EklektikDezIn/MicroComputer-Design/Media/IMG_8726.JPG

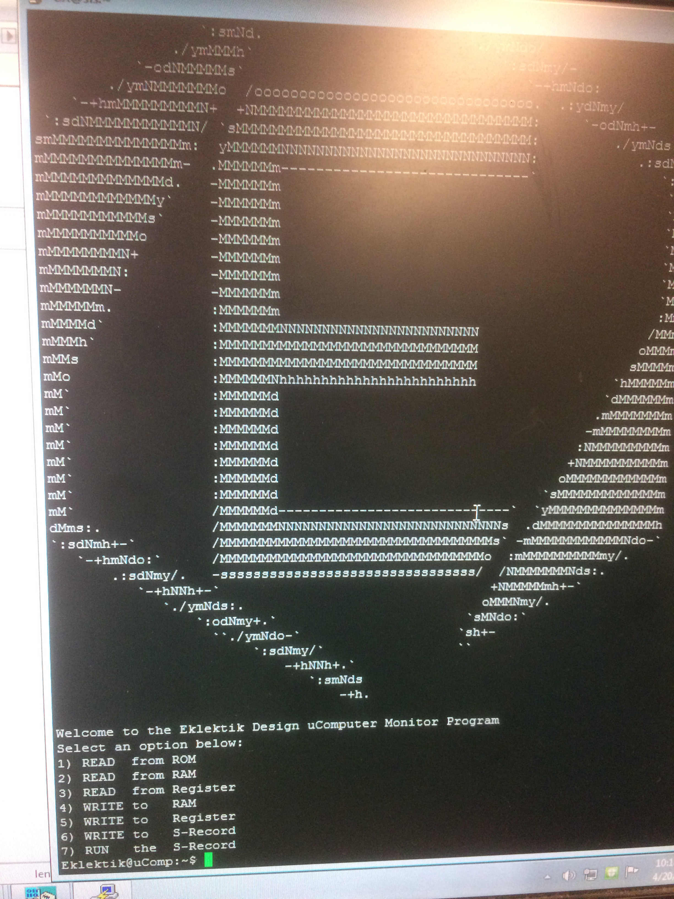
Media/IMG_8726.JPG
