EklektikDezIn/MicroComputer-Design/Media/IMG_8724.JPG

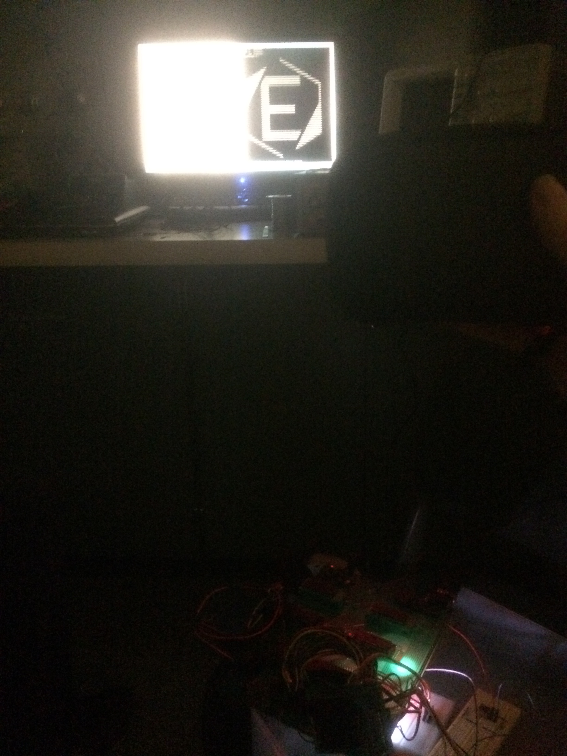
Media/IMG_8724.JPG
