EklektikDezIn/MicroComputer-Design/Reports/Weekly Reports/Report 1.docx

Time: 11 hours

Accomplishments:

- I have completed my initial part selection, however I still plan to meet with the lab assistants and my class mates to verify I have made no errors.
- I have yet to begin schematic drawings, in part due to the snow days which have cancelled classes.

Planned work:

- Next week I plan to confirm my part selection and begin ordering them from online.
- I would also like to complete a portion of the schematics.
- I also plan to diagram the basic flow of the monitor program.

I realize this may be much, but I would prefer to set high goals and fail than to get behind due to not pushing myself. I have allocated 7 hours outside of class to work on this project through the week. I believe it is sufficient for the time being, though I shall extend as needed.

Project % complete:

Hardware: 2%

Software : 0%

Micah Richards Microcomputer Design January 17, 2018
