EklektikDezIn/MicroComputer-Design/Reports/Weekly Reports/Report 2.docx

Time: 9 hours

Accomplishments:

- I expected to begin ordering parts, and I have. I forgot a DIP socket for my CPU and must order that this next week.
- I also began work on the schematics, as planned.
- I completed the software diagram of the code.

Planned work:

- I plan to complete my schematic designs this week and begin work on the PCB symbols.
- I will order the missing DIP socket

Project % complete:

Hardware: 10%

Software : 2%

Micah Richards Microcomputer Design January 24, 2018
