EklektikDezIn/MicroComputer-Design/Reports/Weekly Reports/Report 3.docx

Time: 10 hours

Accomplishments:

- I planned to complete my final schematic design, while it is mostly complete I have many questions which I would like to discuss with the lab assistants before I move forward to the PCB design
- I also planned to begin work on the PCB symbols for the board, and in actuality have completed the entire set.

Planned work:

- This next week I plan to finalize my schematic design through meetings with Chandler and Brian
- I also plan to begin work on the PCB layout during my own scheduled uComp time

Project % complete:

Hardware: 40%

Software : 2%

Micah Richards Microcomputer Design January 31, 2018
