EklektikDezIn/MicroComputer-Design/Reports/Weekly Reports/Report 5.docx

Time: 14 hours

Accomplishments:

- Last week I expected to complete my schematic and finish the first draft of my PCB schematic. Both are complete.

Planned work:

- This week I plan to go through each datasheet and verify pin layouts, chip sizes, needed and unneeded pins, etc. And make appropriate changes to my schematic and data sheet
- Possibly order my board

Project % complete:

Hardware: 58%

Software : 2%

Micah Richards Microcomputer Design February 14, 2018
