EklektikDezIn/MicroComputer-Design/Reports/Weekly Reports/Report 6.docx

Time: 2 hours

Accomplishments:

- Last week I expected to double check my work and order my board. This was done.

Planned work:

- I am uncertain if my board will arrive before the end of this week. If it does, I plan to complete the soldering of components before Wednesday.

Project % complete:

Hardware: 60%

Software : 2%

Micah Richards Microcomputer Design March 5, 2018
