EklektikDezIn/MicroComputer-Design/Reports/Weekly Reports/Report 8.docx

Time: 30 hours

Accomplishments:

- Last report I received my board with a large mistake, this week I have the breakout board assembled and (nearly) fully connected to my board.
- I have drafted the CPLD and ROM Code
- I am beginning work on RAM/ROM testing

Planned work:

- This week I plan to complete the requirements due today for the Software check.
- I may begin more detailed work on my monitor program

Project % complete:

Hardware: 95%

Software : 30%

Micah Richards Microcomputer Design March 21, 2018
