EklektikDezIn/MicroComputer-Design/Reports/Weekly Reports/Charts.xlsx

Week | Hours | Hardware | Software
1 | 11 | 2 | 0
2 | 9 | 10 | 2
3 | 10 | 40 | 2
4 | 8 | 50 | 2
5 | 14 | 58 | 2
6 | 2 | 60 | 2
7 | 5 | 60 | 2
8 | 30 | 95 | 30
9 | 22.5 | 95 | 35
10 | 5 | 100 | 97
11 | 12 | 97 | 97
12 | 5 | 100 | 100
