EklektikDezIn/MicroComputer-Design/Hardware/Datasheets/Barrel Plug Annotated.PNG

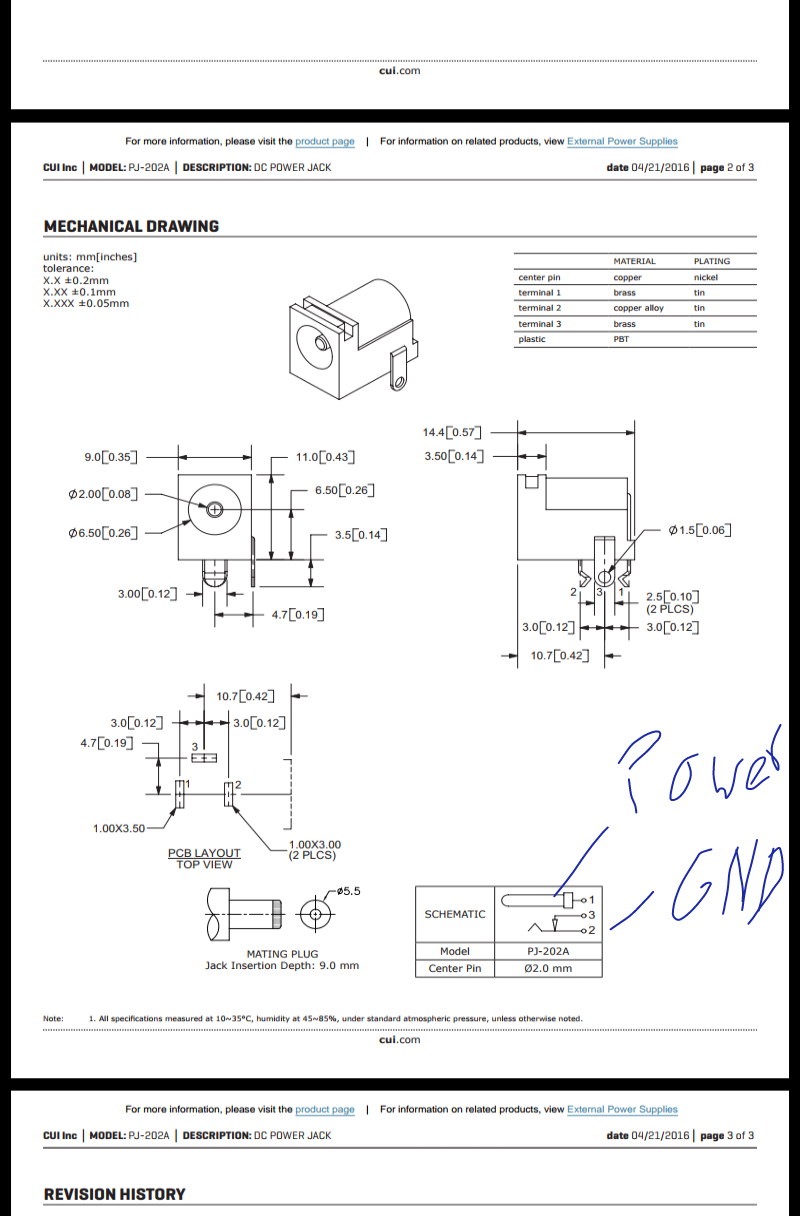
Hardware/Datasheets/Barrel Plug Annotated.PNG
