EklektikDezIn/MicroComputer-Design/Hardware/Datasheets/Pin Layouts/7128_pinout.jpg

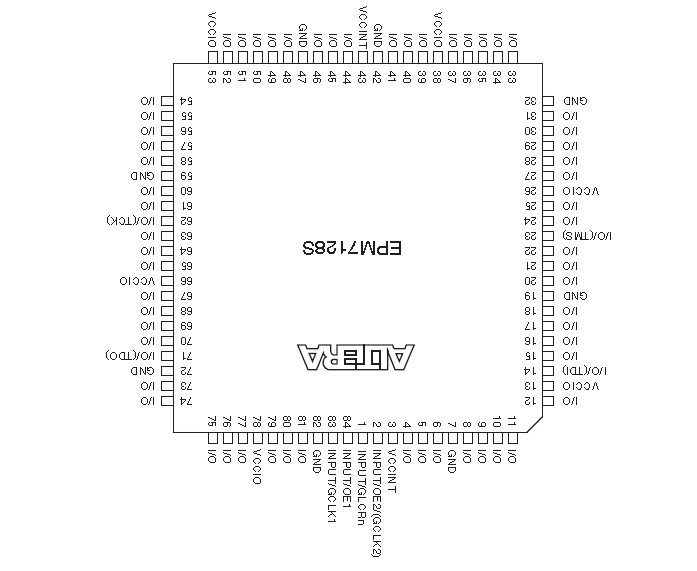
Hardware/Datasheets/Pin Layouts/7128_pinout.jpg
