EklektikDezIn/MicroComputer-Design/Hardware/Datasheets/Pin Layouts/L6515-pinout.jpg

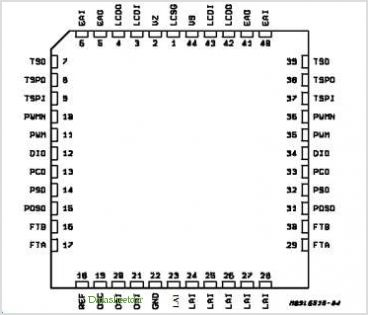
Hardware/Datasheets/Pin Layouts/L6515-pinout.jpg
