EklektikDezIn/MicroComputer-Design/Hardware/Datasheets/Pin Layouts/PLCC to DIP.PNG

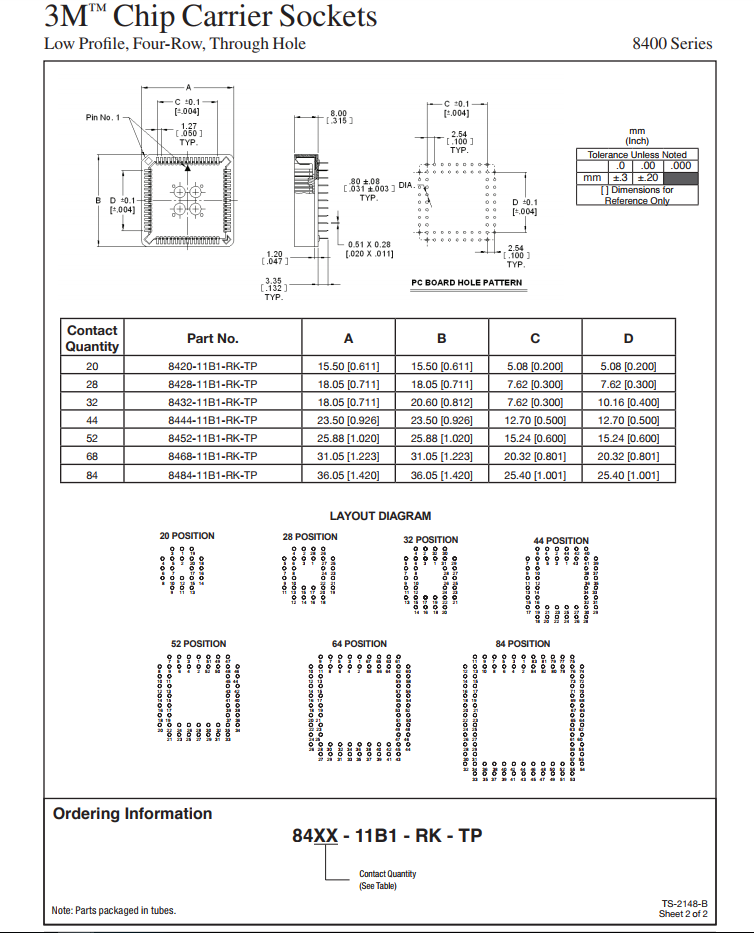
Hardware/Datasheets/Pin Layouts/PLCC to DIP.PNG
