EklektikDezIn/MicroComputer-Design/Media/IMG_8725.JPG

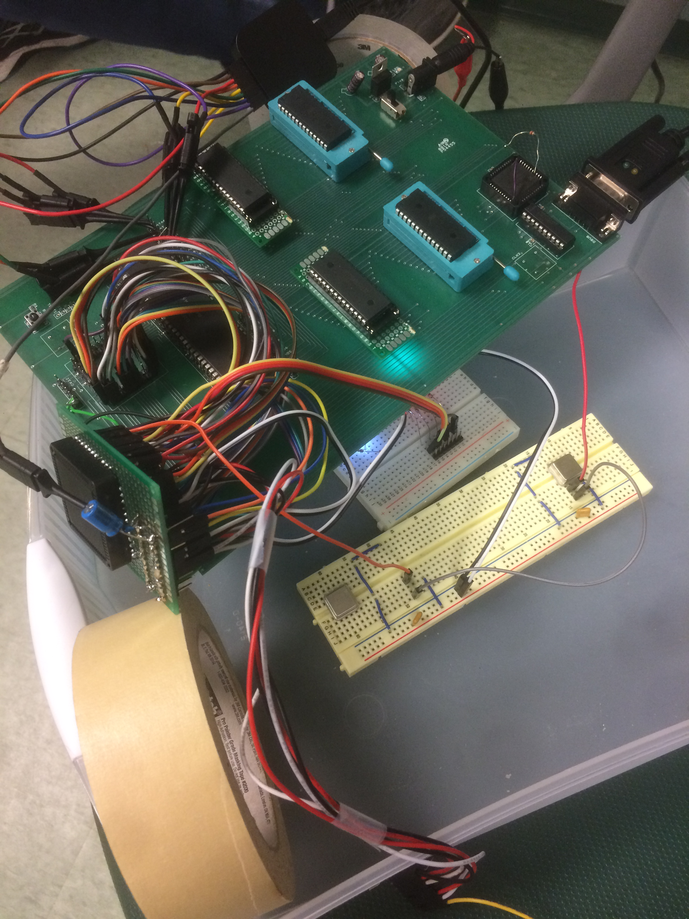
Media/IMG_8725.JPG
