EklektikDezIn/MicroComputer-Design/Reference Documents/project organizer.xls

Sheet: Sheet1
Sheet 1: Parts list
Sheet 2: Supply requirements |  |  |  | MicroComputer Design
Sheet 3: Symbol/Pattern/Component Progress |  |  |  | Sample by Dr. kim
Sheet 4: Time Sheet
Sheet 5: Project Progress
Master Parts List
Item | Quantity | Price(each) | Price(sum) | Description | Manufacturers Part Number |  | Website of Part
Processor | 1 | $13.45 | $13.45 | 6800 Series CPU 16-bit (10MHz) # Dual in-line Package # 64-pins | MC68000L10 | J | http://www.jameco.com/webapp/wcs/stores/servlet/ProductDisplay?productId=25291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
Processor Socket | 1 | $7.20 | $7.20 | IC SOCKET 64 PIN .900 GOLD | 110-13-964-41-001000 |  | http://search.digikey.com/scripts/DkSearch/dksus.dll?Detail?name=ED56646-ND
CPU Oscillator | 1 | $2.94 | $2.94 | OSCILLATOR 8.0000MHZ PDIP | SG-51P 8.0000MC |  | http://search.digikey.com/scripts/DkSearch/dksus.dll?Detail?name=SE1707-ND
CPU Oscillator Socket | 1 | $1.58 | $1.58 | IC SOCKET 14 PIN .300 GOLD | 110-13-314-41-001000 |  | http://search.digikey.com/scripts/DkSearch/dksus.dll?Detail?name=ED56143-ND
CPLD | 1 | $17.00 | $17.00 | IC CPLD 72 MCELL C-TEMP 84-PLCC | XC9572-7PC84C |  | http://search.digikey.com/scripts/DkSearch/dksus.dll?Detail?name=122-1262-ND
CPLD Socket | 1 | $2.67 | $2.67 | IC SOCKET PLCC 84POS GOLD | A-CCS84-G-R |  | http://search.digikey.com/scripts/DkSearch/dksus.dll?Detail?name=AE10067-ND
Jtag | 1 | $0.55 | $0.55 | CONN HEADER 6POS .100 VERT TIN | 22-28-4061 | m | http://www.mouser.com/Search/ProductDetail.aspx?qs=GAPJcf4kvdv3Xd3iPYTA6w%3d%3d
DUART | 1 | $5.50 | $5.50 | IC UART DUAL 44-PLCC | SCC68681C1A44-S |  | http://search.digikey.com/scripts/DkSearch/dksus.dll?Detail?name=568-3527-5-ND
Duart Socket | 1 | $1.77 | $1.77 | IC SOCKET PLCC 44POS GOLD | A-CCS44-G-R |  | http://search.digikey.com/scripts/DkSearch/dksus.dll?Detail?name=AE10064-ND
Duart CLK | 1 | $1.88 | $1.88 | OSC 3.6864 MHZ 5.0V FULL SIZE | ECS-100AX-036 |  | http://search.digikey.com/scripts/DkSearch/dksus.dll?Detail?name=X941-ND
RS232 Driver | 1 | $10.76 | $10.76 | IC 2DVR/2RCVR RS232 5V 20-DIP | MAX233ACPP+G36 |  | http://search.digikey.com/scripts/DkSearch/dksus.dll?Detail?name=MAX233ACPP%2BG36-ND
RS232 Driver Socket | 1 | $2.25 | $2.25 | IC SOCKET 20 PIN .300 GOLD | 110-13-320-41-001000 |  | http://search.digikey.com/scripts/DkSearch/dksus.dll?Detail?name=ED56203-ND
Supervisory Chip | 1 | $7.23 | $7.23 | IC MPU SUPERVISORY CIRCUIT 8-DIP | MAX694CPA+ |  | http://search.digikey.com/scripts/DkSearch/dksus.dll?Detail?name=MAX694CPA%2B-ND
Super-Chip Socket | 1 | $0.90 | $0.90 | IC SOCKET 8 PIN .300 GOLD | 110-13-308-41-001000 |  | http://search.digikey.com/scripts/DkSearch/dksus.dll?Detail?name=ED56083-ND
D-Sub connector | 1 | $1.76 | $1.76 | CONN D-SUB RCPT R/A 9POS GOLD/FL | 1734354-1 |  | http://search.digikey.com/scripts/DkSearch/dksus.dll?Detail?name=A35107-ND
Ram | 2 | $1.99 | $3.98 | (256kb)32K X 8 STANDARD SRAM, 35 ns,Pdip 28 | CY7C199-35PC | J | http://www.jameco.com/webapp/wcs/stores/servlet/ProductDisplay?productId=242376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
Rom | 2 | $7.10 | $14.20 | IC EEPROM 256K 120NS 28DIP | AT28HC256-12PU-ND |  | http://search.digikey.com/scripts/DkSearch/dksus.dll?Detail?name=AT28HC256-12PU-ND
Ram Socket | 2 | $3.15 | $6.30 | IC SOCKET 28 PIN .300 GOLD | 110-13-328-41-001000 |  | http://search.digikey.com/scripts/DkSearch/dksus.dll?Detail?name=ED56283-ND
Rom Socket | 2 | $3.15 | $6.30 | IC SOCKET 28 PIN .600 GOLD | 110-13-628-41-001000 |  | http://search.digikey.com/scripts/DkSearch/dksus.dll?Detail?name=ED56286-ND
5v Regulator | 1 | $1.19 | $1.19 | IC REG 2A 5V FIXED TO-220 | PQ050RDA2SZH |  | http://search.digikey.com/scripts/DkSearch/dksus.dll?Detail?name=425-2629-5-ND
ON/OFF switch | 1 | $1.95 | $1.95 | Miniature Toggle Switches SPDT ON-ON STD LVR | 10TC610 | m | http://www.mouser.com/Search/ProductDetail.aspx?qs=iZD9pWtnGRemNKjEFHFHNQ%3d%3d
Reset Button | 1 | $0.45 | $0.45 | SWITCH TACT 6MM SMD MOM 160GF | B3S-1000 |  | http://search.digikey.com/scripts/DkSearch/dksus.dll?Detail?name=SW415-ND
Test Points | 50 | $0.30 | $15.10 | TEST POINT PC COMPACT .063"D BLK | 5011K-ND |  | http://search.digikey.com/scripts/DkSearch/dksus.dll?Detail?name=5011K-ND
Red Test Point | 2 | $0.40 | $0.80 | Test Points RED TEST POINT | 5010K-ND | m | http://www.mouser.com/Search/ProductDetail.aspx?qs=qOqV1E1P08SzD%252bWfk1wMXQ%3d%3d
LEDs | 25 | $0.25 | $6.25 | 0805 LED SMD Standard Blue Water Clr 140mcd 475nm | 598-8190-107F | m | http://www.mouser.com/Search/ProductDetail.aspx?qs=7JStj%2fjQ2SEA%252b%2fUbcPiheQ%3d%3d
Capacitor .33 uF | 10 | $0.23 | $2.28 | (using 1- minimum 10) CAP CER .33UF 10V 10% X7R 0805 | GRM216R71A334KC01D |  | http://search.digikey.com/scripts/DkSearch/dksus.dll?Detail?name=490-1694-1-ND
Capacitor 47 uF | 1 | $1.88 | $1.88 | CAP CER 47UF 6.3V X5R 20% 1206 | 12066D476MAT2A |  | http://search.digikey.com/scripts/DkSearch/dksus.dll?Detail?name=478-4532-1-ND
Capacitor .1 uF | 20 | $0.08 | $1.64 | CAP .10UF 16V CERAMIC X7R 0805 | CC0805KRX7R7BB104 |  | http://search.digikey.com/scripts/DkSearch/dksus.dll?Detail?name=311-1142-1-ND
Resistor 100 Ohm | 20 | $0.03 | $0.60 | RES 100 OHM 1/8W 5% 0805 SMD | MCR10EZPJ101 |  | http://search.digikey.com/scripts/DkSearch/dksus.dll?Detail?name=RHM100ARCT-ND
PCB Board | 1 | $33.00 | $33.00
PCB Shipping and H | 1 | $24.69 | $24.69
Digikey Shipping | 1 | $11.31 | $11.31
Mouser Shipping+Tax | 1 | $10.65 | $10.65
Jameco Shipping | 1 | $13.29 | $13.29
 |  | Total Cost w/ Shipping | $233.30
 |  |  |  | Shipping Costs | $59.94

Sheet: Sheet2
 |  | MicroComputer Design
Item | Supply Voltage | Current Requirments | Website of Part
Processor (PLCC recom.) | 5v | 1.5 A max | http://www.jameco.com/webapp/wcs/stores/servlet/ProductDisplay?productId=25291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
Processor Socket (PLCC recom.) |  |  | http://search.digikey.com/scripts/DkSearch/dksus.dll?Detail?name=ED56646-ND
CPU Oscillator (8Mhz reco. & can be used for CPLD clock w/o dividing) | 5v | 23 mA max | http://search.digikey.com/scripts/DkSearch/dksus.dll?Detail?name=SE1707-ND
CPU Oscillator Socket |  |  | http://search.digikey.com/scripts/DkSearch/dksus.dll?Detail?name=ED56143-ND
CPLD | 5v | 65 mA max | http://search.digikey.com/scripts/DkSearch/dksus.dll?Detail?name=122-1262-ND
CPLD Socket (PLCC recom.) |  |  | http://search.digikey.com/scripts/DkSearch/dksus.dll?Detail?name=AE10067-ND
Jtag (6pin) |  |  | http://search.digikey.com/scripts/DkSearch/dksus.dll?Detail?name=WM6606-ND
DUART | 5v | 10 mA | http://search.digikey.com/scripts/DkSearch/dksus.dll?Detail?name=568-3527-5-ND
Duart Socket |  |  | http://search.digikey.com/scripts/DkSearch/dksus.dll?Detail?name=AE10064-ND
Duart CLK (oscillator) |  |  | http://search.digikey.com/scripts/DkSearch/dksus.dll?Detail?name=X941-ND
RS232 Driver | 5v | 15uA | http://search.digikey.com/scripts/DkSearch/dksus.dll?Detail?name=MAX233ACPP%2BG36-ND
RS232 Driver Socket |  |  | http://search.digikey.com/scripts/DkSearch/dksus.dll?Detail?name=ED56203-ND
Supervisory Chip | 5v | 10mA | http://search.digikey.com/scripts/DkSearch/dksus.dll?Detail?name=MAX694CPA%2B-ND
Super-Chip Socket |  |  | http://search.digikey.com/scripts/DkSearch/dksus.dll?Detail?name=ED56083-ND
D-Sub connector (serial cable connector) |  |  | http://search.digikey.com/scripts/DkSearch/dksus.dll?Detail?name=A35107-ND
Ram | 5v | 150mA | http://www.jameco.com/webapp/wcs/stores/servlet/ProductDisplay?productId=242376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
Rom | 5v | 80mA | http://search.digikey.com/scripts/DkSearch/dksus.dll?Detail?name=AT28HC256-70PI-ND
Ram Socket |  |  | http://search.digikey.com/scripts/DkSearch/dksus.dll?Detail?name=ED56283-ND
Rom Socket |  |  | http://search.digikey.com/scripts/DkSearch/dksus.dll?Detail?name=ED56286-ND
5v Regulator | 7-20VMAX |  | http://search.digikey.com/scripts/DkSearch/dksus.dll?Detail?name=425-2629-5-ND
ON/OFF switch |  |  | http://www.mouser.com/Search/ProductDetail.aspx?qs=iZD9pWtnGRemNKjEFHFHNQ%3d%3d
Reset Button |  |  | http://search.digikey.com/scripts/DkSearch/dksus.dll?Detail?name=SW415-ND
PCB Board
Resistors
Capacitors
Total: | 5v | 1.838 Amps (at most)
capacitive and current loading charts (high and low state) for each IC can be found on the data sheets.

Sheet: Sheet3
Item (x = complete) | Symbol | Pattern | Component
Processor | X | n/a | X
Processor Socket | n/a | X | n/a
CPU Oscillator | X | n/a | X
CPU Oscillator Socket | n/a | X | n/a
CPLD | X | n/a | X
CPLD Socket | n/a | X | n/a
Jtag | X | X | X
DUART | X | n/a | X
Duart Socket | N/A | X | n/a
Duart CLK | X | X | X
RS232 Driver | X | n/a | X
RS232 Driver Socket | N/A | X | n/a
Supervisory Chip | X | n/a | X
Super-Chip Socket | N/A | X | n/a
D-Sub connector | X | X | X
Ram | X | n/a | X
Rom | X | n/a | X
Ram Socket | N/A | X | n/a
Rom Socket | N/A | X | n/a
5v Regulator | X | X | X
ON/OFF switch | X | X | X
Reset Button | X | X | X
CAP (capacitors) | X |  | X
Resistors | X | X(0805) | X
LED | X |  | X
PCB Board

Sheet: Sheet4
Time Sheet
 | Hours (Estimated)
Week 1 | 20 | Found parts, and data sheets, worked on understanding the project
Week 2 | 6 | started symbols, meeting with a lab assistant to discuss monitor program
 | 7 | Finished symbols and some of the patterns
 | 4 | Worked on Patterns
 | 2 | Worked on Monitor Program, Weekly report
Week 3 | 2 | Finished Patterns
 | 2 | Finished Components
 | 8 | Completed Schematic
Week 4 | 5 | Added LEDs and Test Points to CPLD (schematic), Named nets
 | 2 | Naming nets, researching PCB layout information
 | 2 | Ordering parts
Week 5 | 10 | PCB layout
 | 4 | Verifying / Ordering Board / Finalizing board / Checking with Cam
Week 6 | 6 | Soldering/ Verifying power pins
Week 7 | 5 | Programming VHDL / DL/Installing New Xilinx on Lab Computers
Week 8 | 3 | Figuring out what the CPLD logic should be for read/write cycles.
 | 6 | Installing Xilinx on computer in lab/ Figuring out VHDL basic test code for LEDs
 | 5 | Programming VHDL CPLD Code and some test Code to figure out current
Week 9 | 0 | Projects/Tests in other classes
Week 10 | 7 | Verified 50% of VHDL code // Tested and verified that ROM works with simple NOP program
 | 11.5 | Verified Ram and Rom works in CPLD. Started Monitor program and attemped serial communication.
 | 9 | Fixed Grounding problem with DUART. Achieved successful 2 way Serial communication with the computer, Computer displays a menu now, and echos text
 | 9 | Added messages and error checking for each initial choice (out of 5 choices) Worked on triple output problem. Tried book code but it didn't work for DUART
 | 8 | FINALLY FIXED THE DUART PROBLEM!!! I now have full serial communication with the computer
 | 4 | Programmed input and output routines
Week 11 | 11.5 | Programmed the view memory (debugged software code that didn't work in hardware) // Programmed modify RAM code
 | 4 | Fixed the computer so it could do byte reads. (the CE lines on the RAM were wired together, so I could only do word writes
 | 6 | Programmed the View and modify registers (Option 2)
 | 10 | Programmed Load Program code for S-Records.
 | 3 | Programmed the Run Program command
Total | 182 | hours

Sheet: Sheet5
IV. Project Progress
Task | Progress
Choose parts | Complete
Design Patterns | Complete
Design Symbols | Complete | Hardware Errors Found
Outline Flow Chart | Complete | On-off toggle backwards
Design Schematic | Complete | Didn't label JTAG clearly
Design Board layout | Complete | Used a female serial conector instead of a male connection
Order Parts | Complete | RS232 pattern width to wide on PCB
Order Board | Complete | Had to add a resistor to Supervisor
Assemble board (solder everything on) (2-5 hrs) | Complete | Pin 5 on Serial connector was not grounded
Write VHDL code for board if using CPLD (2-16 hrs) | Complete | ROM CE lines were tied together therefore I could not do Byte writes
Load simple loop program into Rom and test computer board (1-5 hrs) | Complete
Troubleshoot hardware/ get board working (10 – 80 hrs) | Complete | Software
Develop monitor program (20 – 60 hrs) | Complete | The monitor program displays any key I push 3 times instead of just once.
Get serial communication working | Complete | Adding to an Address regester works in simulation but not on hardware
Code for reading/writing RAM | Complete | Simulator clears out upper part of Regester when doing Word or byte moves
Display basic menu and be able to select options | Complete | Hardware doesn't clear the upper part of the register when doing
Develop necessary functions of monitor program. | Complete
Final test day with working hardware and software | Complete
