EklektikDezIn/MicroComputer-Design/Hardware/Exports/Board V2 Color.pdf

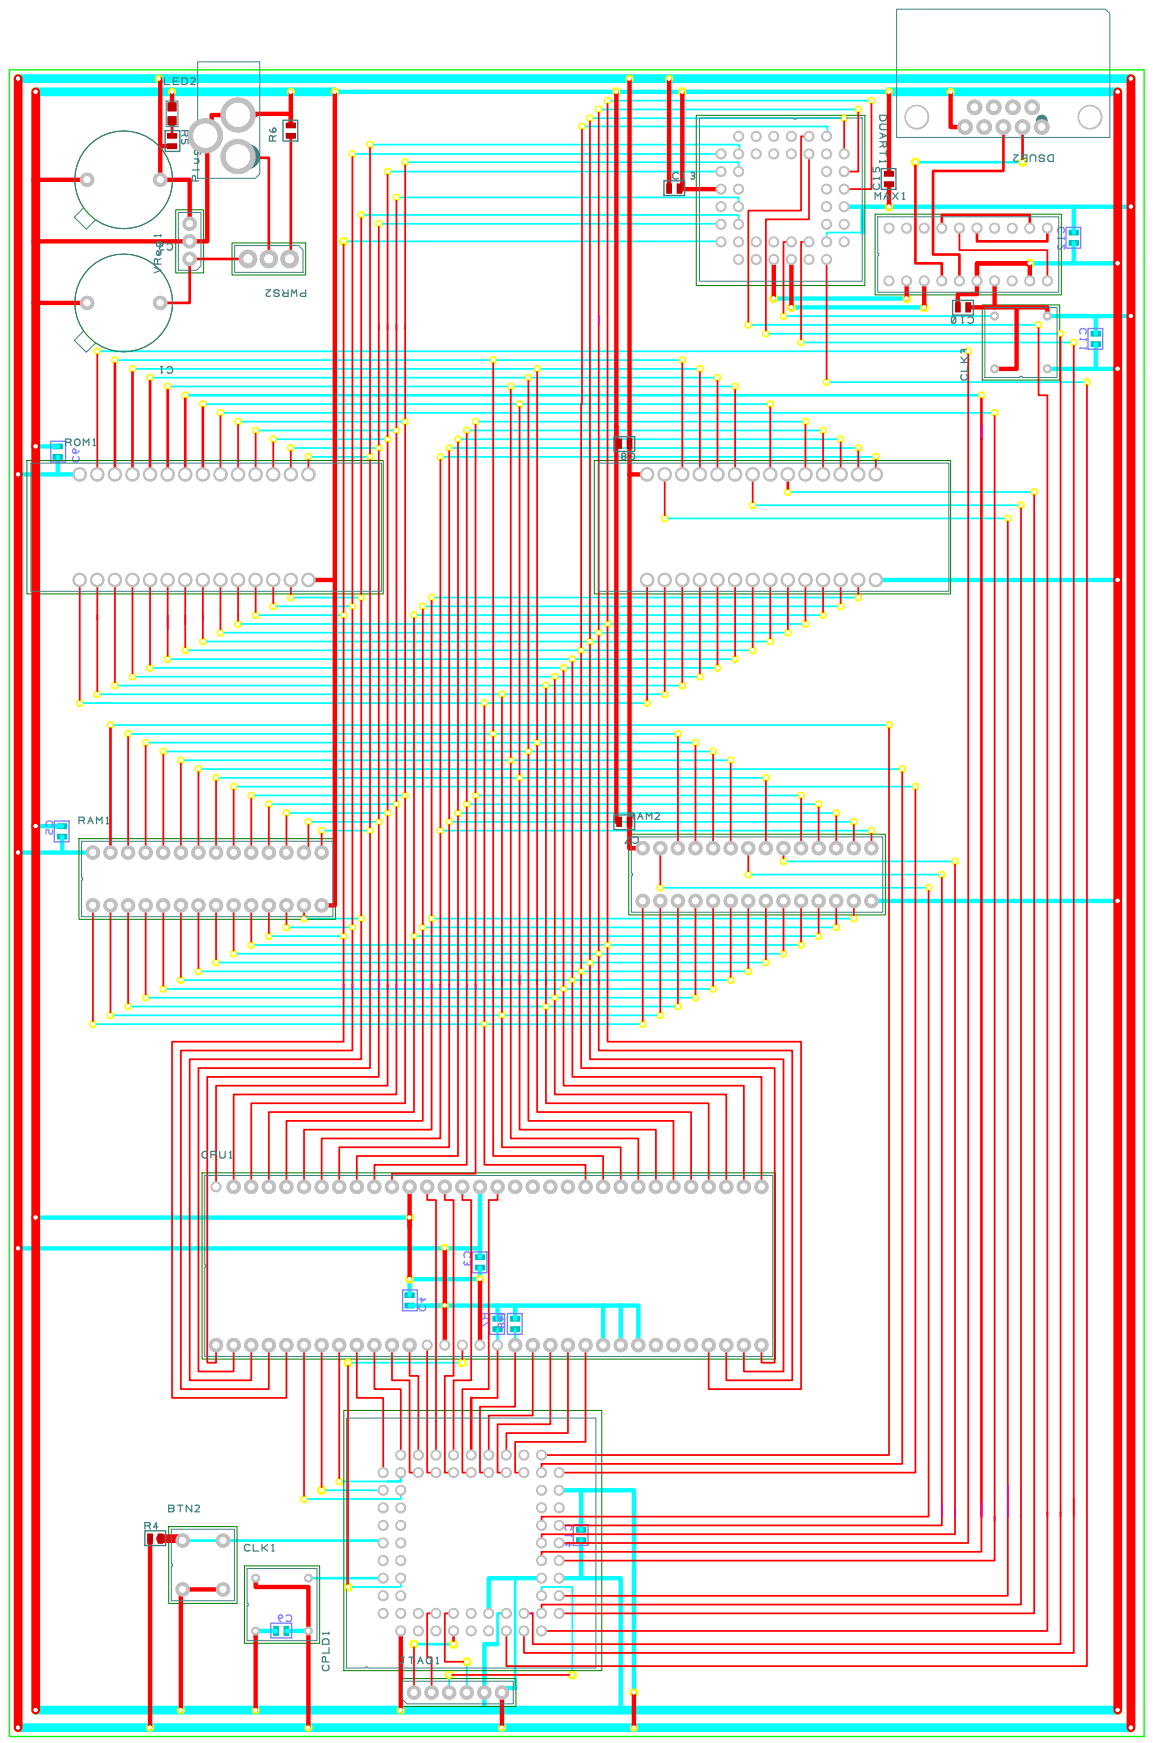
[picture p27: page 1]
