EklektikDezIn/MicroComputer-Design/Hardware/Exports/Board V2.pdf

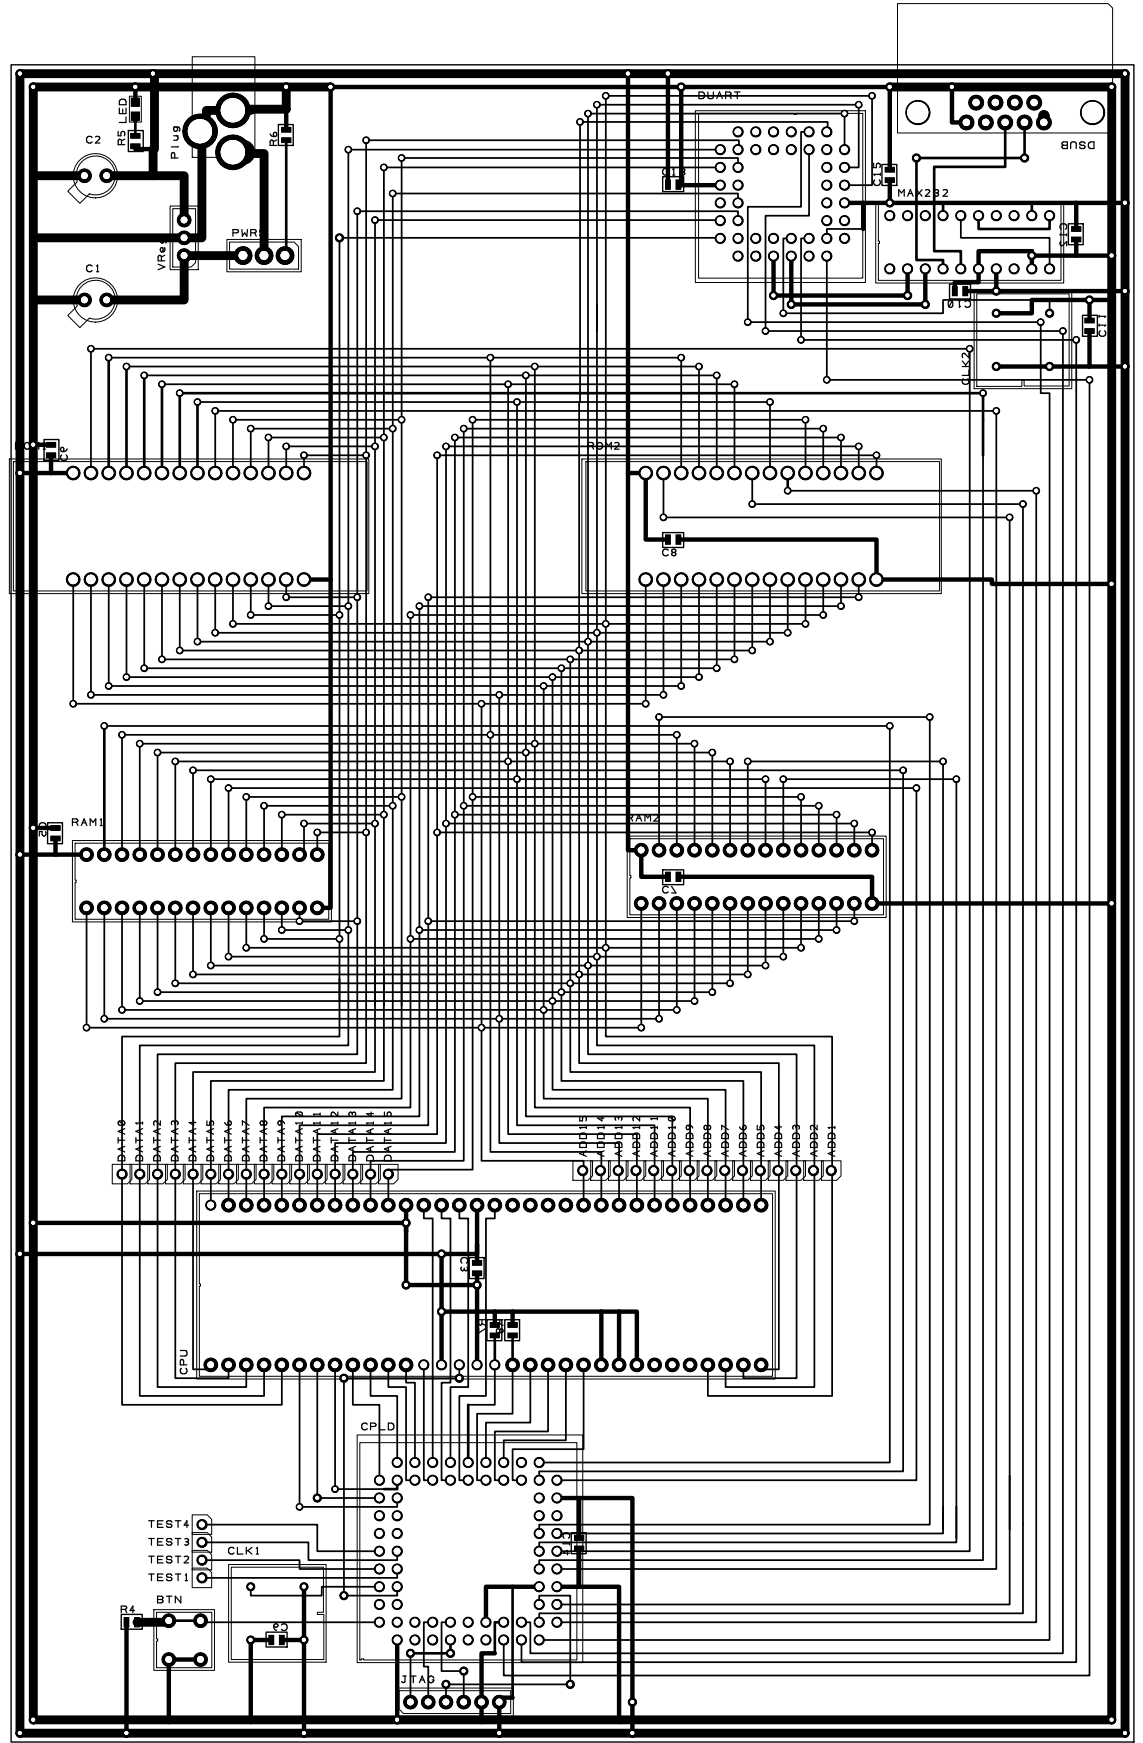
[picture p28: page 1]
