EklektikDezIn/MicroComputer-Design/Hardware/Exports/Schematic V2.pdf

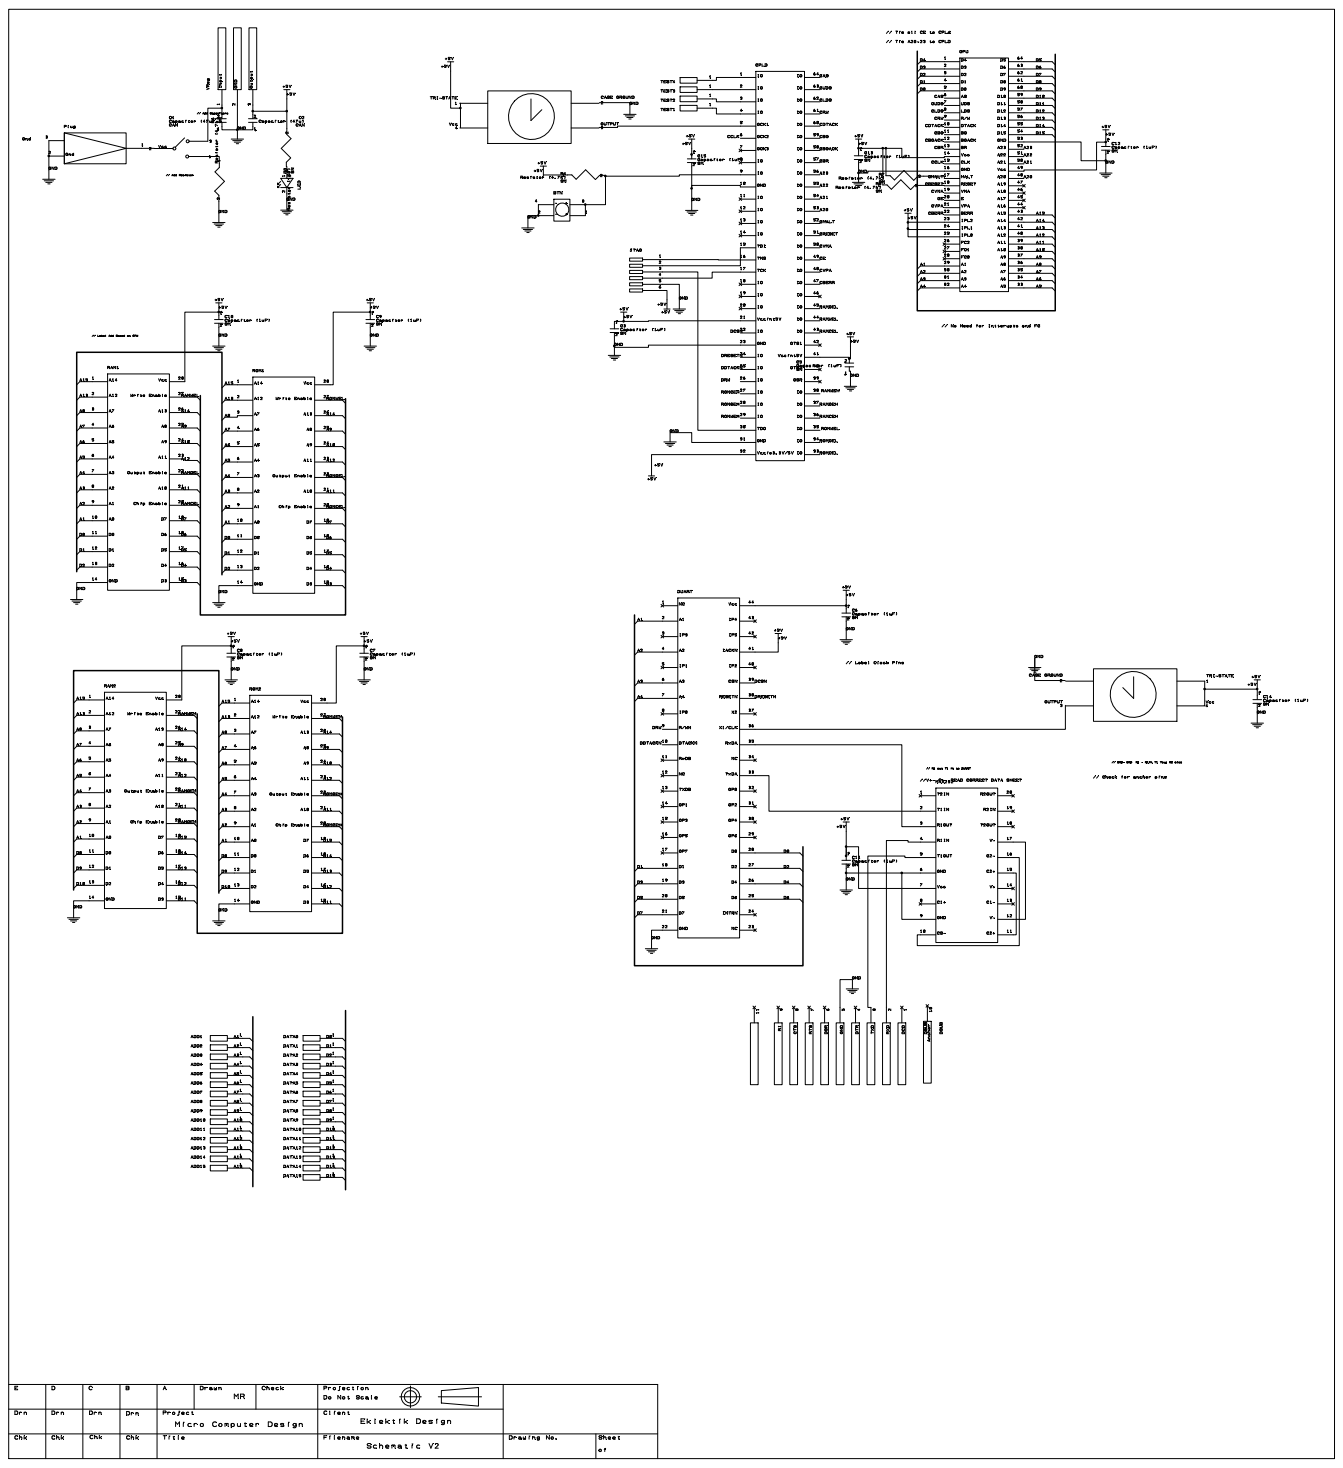
[picture p29: page 1]
