EklektikDezIn/MicroComputer-Design/Hardware/Past Versions/Exports/Schematic V0.5Filled.pdf

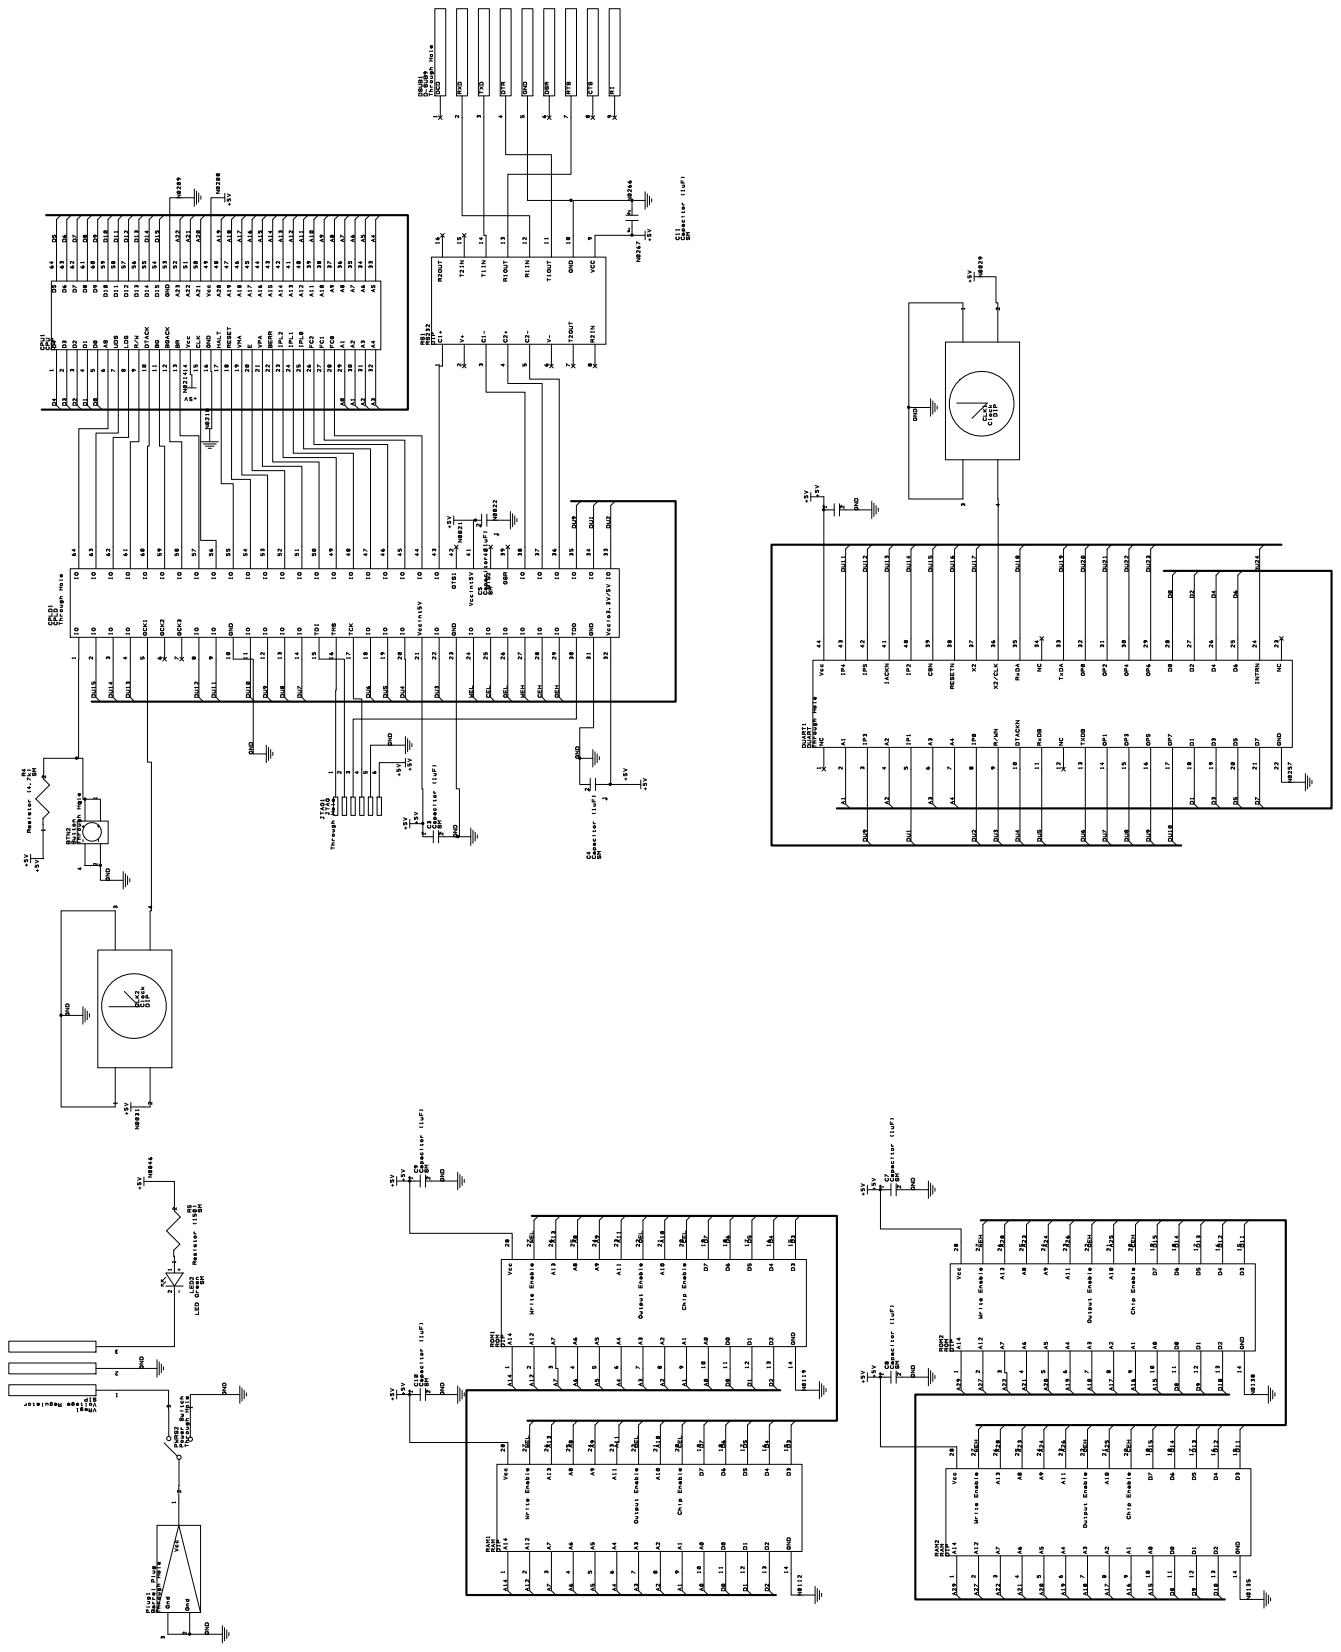
[picture p30: page 1]
