EklektikDezIn/MicroComputer-Design/Hardware/Past Versions/Exports/Schematic V1.pdf

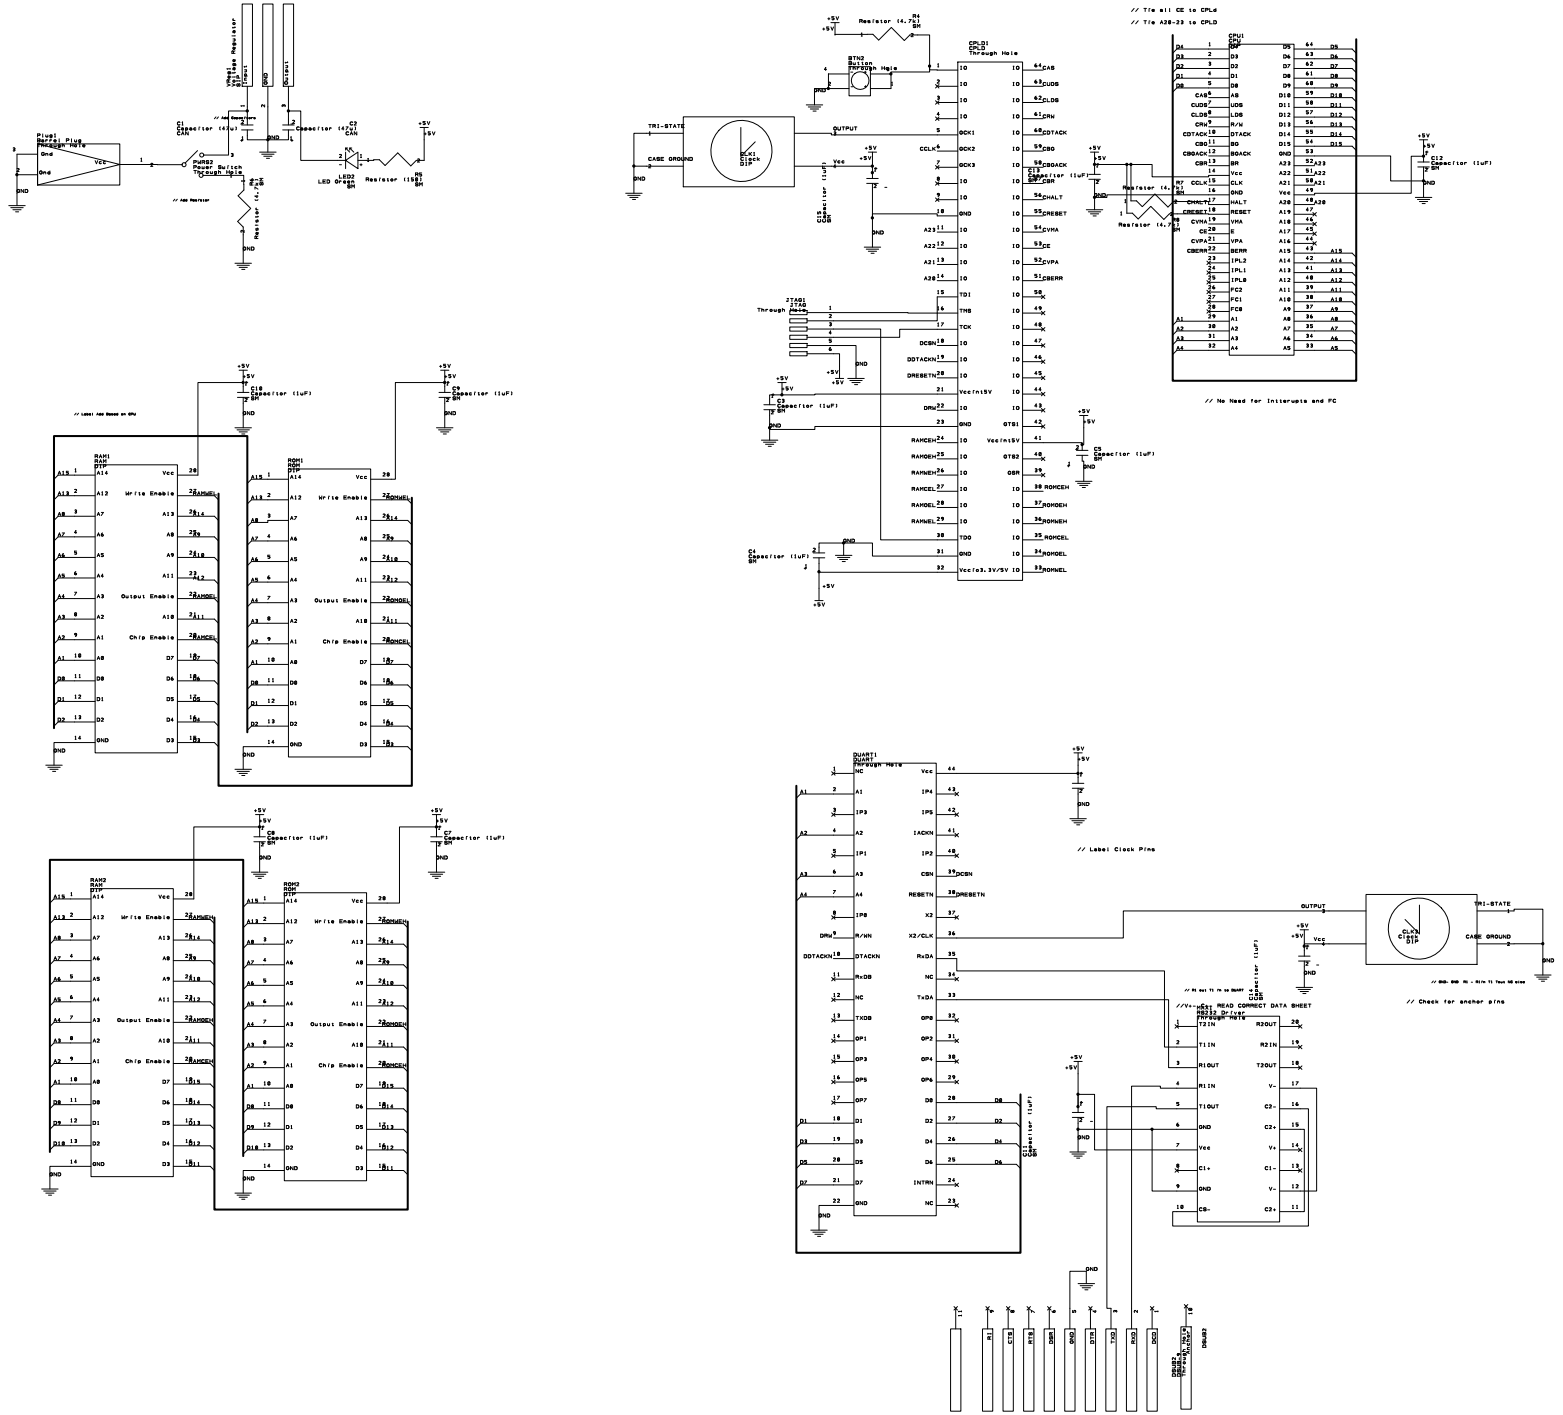
[picture p31: page 1]
