EklektikDezIn/MicroComputer-Design/(list of files, drawings)

Other design files:
Hardware/Past Versions/[SBC Schematic V 1.3].pcb
Hardware/Past Versions/[~SBC Schematic V 1.0].pcb
Hardware/Past Versions/[~SBC Schematic V 1.1].pcb
Hardware/Past Versions/SBC Schematic V 1.0.pcb
Hardware/Past Versions/SBC Schematic V 1.1.pcb
Hardware/Past Versions/SBC Schematic V 1.2.pcb
Hardware/Past Versions/SBC Schematic V 1.4.pcb
Hardware/Past Versions/SBC Schematic V 1.5.pcb
Hardware/Past Versions/~SBC Schematic V 1.2.pcb
Hardware/Past Versions/~SBC Schematic V 1.3.pcb
Hardware/Past Versions/~SBC Schematic V 1.4.pcb
Hardware/Past Versions/~SBC Schematic V 1.5.pcb
Hardware/Past Versions/~~SBC Schematic V 1.1.pcb
Hardware/Project Files/SBC Schematic V 2.pcb
Hardware/Project Files/~SBC Schematic V 2.pcb
